siderakb/pmw3360-pcb/pmw3360_pcb_ffc/readme.md

# PMW3360 PCB FFC/FPC Connector

- `J1`: 0.5mm 8pin FFC/FPC connector (AFC01-S08FCA-00).
- Mounting holes: 4x M2 (∅2.2mm).

## PCB Characteristics

- Copper layer count: 2
- Board overall dimensions: 27 mm x 22.5 mm
- Min track/spacing: 0.2 mm / 0.2 mm
- Min hole diameter: 0.3 mm
- Castellated pads: No
- Plated board edge: No
- Edge card connectors: No

## Changelog

### [F.1.0] - 2023-12-15

- Changed LDO from TPS73601DBV to TLV74318PDBVR.
- Changed R5 to C5.

### [F.0.0] - 2023-06-29

- Reduce the board size to 27 x 22.5 mm.
- Update PWM3360 footprint (reduce the size of the pads).

### [3.1.0] - 2023-05-27

- First FFC/FPC edition release.
