siderakb/pmw3360-pcb/pmw3360_pcb_jst/readme.md

# PMW3360 PCB JST GH Connector

- `J1`: JST GH 1.25mm connector (SM08B-GHS-TB(LF)(SN)).
- Mounting holes: 4x M2 (∅2.2mm).

## PCB Characteristics

- Copper layer count: 2
- Board overall dimensions: 27 mm x 28 mm
- Min track/spacing: 0.2 mm / 0.2 mm
- Min hole diameter: 0.3 mm
- Castellated pads: No
- Plated board edge: No
- Edge card connectors: No

## Changelog

### [J.1.0] - 2023-12-15

- Changed LDO from TPS73601DBV to TLV74318PDBVR.
- Changed R5 to C5.

### [J.0.0] - 2023-06-29

- Update PWM3360 footprint (reduce the size of the pads).

### [3.0.0] - 2023-05-27

- First JST edition release.
