siderakb/pmw3360-pcb/pmw3360_pcb_jst/pmw3360_pcb_jst.kicad_pcb

## KiCad design pmw3360_pcb_jst/pmw3360_pcb_jst.kicad_pcb (2023-12-15)

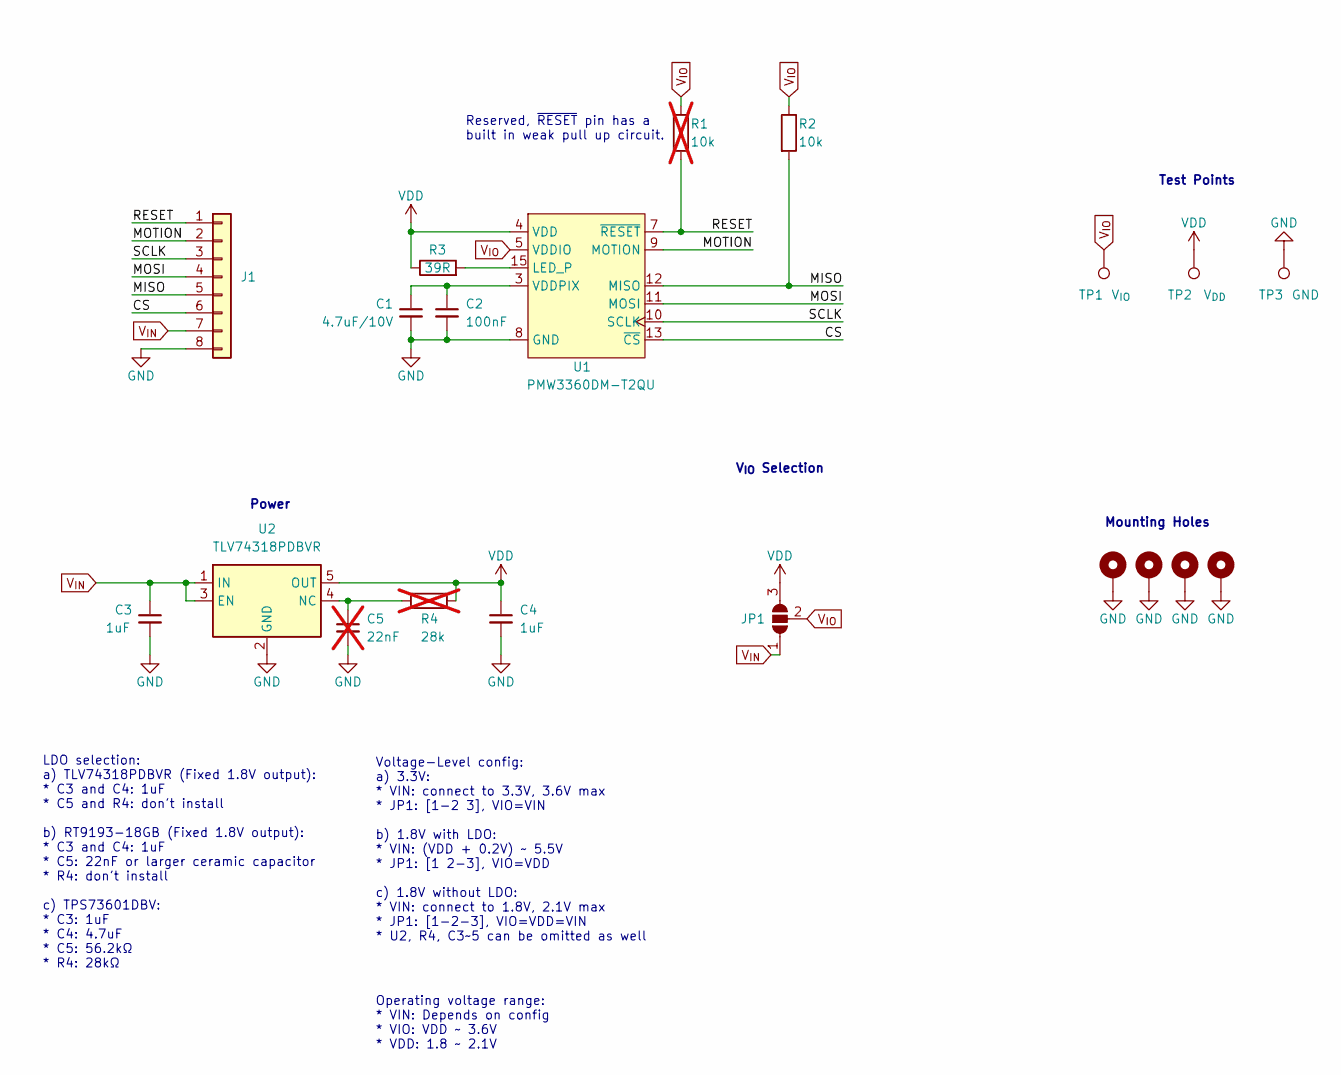
[picture p4: schematic pmw3360_pcb_jst.kicad_sch, PMW3360 PCB]

Parts:
C1: 4.7uF/10V; C_0603_1608Metric_Pad1.08x0.95mm_HandSolder
C2: 100nF; C_0603_1608Metric_Pad1.08x0.95mm_HandSolder
C3, C4: 1uF; C_0603_1608Metric_Pad1.08x0.95mm_HandSolder
C5: 22nF; C_0603_1608Metric_Pad1.08x0.95mm_HandSolder; Mfr. # CL10B223KB8NNNC; LCSC C21122; not fitted
H1, H2, H3, H4: MountingHole_Pad; MountingHole_2.2mm_M2_ISO14580_Pad
J1: Conn_01x08; JST_GH_SM08B-GHS-TB_1x08-1MP_P1.25mm_Horizontal
JP1: SolderJumper_3_Open; SolderJumper-3_P1.3mm_Open_RoundedPad1.0x1.5mm_NumberLabels
R1: 10k; R_0603_1608Metric_Pad0.98x0.95mm_HandSolder; not fitted
R2: 10k; R_0603_1608Metric_Pad0.98x0.95mm_HandSolder
R3: 39R; R_0603_1608Metric_Pad0.98x0.95mm_HandSolder
R4: 28k; R_0603_1608Metric_Pad0.98x0.95mm_HandSolder; not fitted
TP1: V_{IO}; TestPoint_Pad_D1.0mm
TP2: V_{DD}; TestPoint_Pad_D1.0mm
TP3: GND; TestPoint_Pad_D1.0mm
U1: PMW3360DM-T2QU; PMW3360DM-T2QU 16Pin
U2: TLV74318PDBVR; SOT-23-5; Mfr. # TLV74318PDBVR; LCSC C485152

Connections:
/CS: J1.6, U1.13 (~CS)
/MISO: J1.5, R2.2, U1.12 (MISO)
/MOSI: J1.4, U1.11 (MOSI)
/MOTION: J1.2, U1.9 (MOTION)
/RESET: J1.1, R1.2, U1.7 (~RESET)
/SCLK: J1.3, U1.10 (SCLK)
GND: C1.2, C2.2, C3.2, C4.2, C5.2, H1.1, H2.1, H3.1, H4.1, J1.8, TP3.1, U1.8 (GND), U2.2 (GND)
unnamed: R3.2, U1.15 (LED_P)
unnamed: C1.1, C2.1, U1.3 (VDDPIX)
unnamed: C5.1, R4.2, U2.4 (NC)
VDD: C4.1, JP1.3 (B), R3.1, R4.1, TP2.1, U1.4 (VDD), U2.5 (OUT)
V_{IN}: C3.1, J1.7, JP1.1 (A), U2.1 (IN), U2.3 (EN)
V_{IO}: JP1.2 (C), R1.1, R2.1, TP1.1, U1.5 (VDDIO)

Notes on the sheet:
Mounting Holes
Test Points
V_{IO} Selection
LDO selection: a) TLV74318PDBVR (Fixed 1.8V output): * C3 and C4: 1uF * C5 and R4: don't install b) RT9193-18GB (Fixed 1.8V output): * C3 and C4: 1uF * C5: 22nF or larger ceramic capacitor * R4: don't install c) TPS73601DBV: * C3: 1uF * C4: 4.7uF * C5: 56.2kΩ * R4: 28kΩ
Operating voltage range: * VIN: Depends on config * VIO: VDD ~ 3.6V * VDD: 1.8 ~ 2.1V
Power
Reserved, ~{RESET} pin has a built in weak pull up circuit.
Voltage-Level config: a) 3.3V: * VIN: connect to 3.3V, 3.6V max * JP1: [1-2 3], VIO=VIN b) 1.8V with LDO: * VIN: (VDD + 0.2V) ~ 5.5V * JP1: [1 2-3], VIO=VDD c) 1.8V without LDO: * VIN: connect to 1.8V, 2.1V max * JP1: [1-2-3], VIO=VDD=VIN * U2, R4, C3~5 can be omitted as well

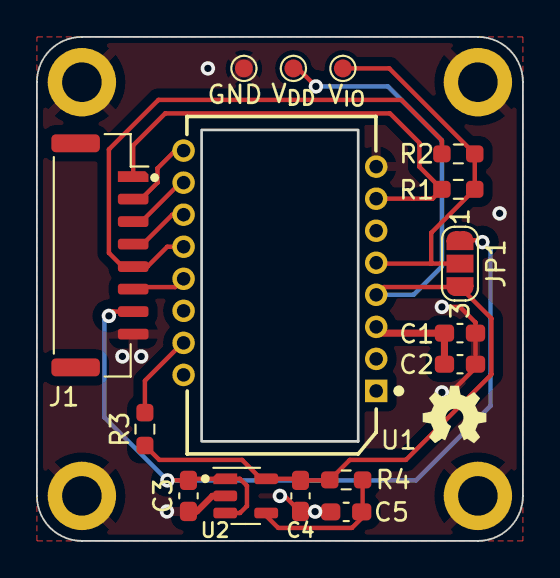
[picture p5: board pmw3360_pcb_jst.kicad_pcb from above]

Board: 2 copper layers, 27.0 x 28.0 mm, 20 parts (0 on the bottom side), 13 nets.
