siderakb/pmw3360-pcb/(commit log)

2022-08-20 Add KiCAD files
    [PMW3360_PCB.kicad_pcb, PMW3360_PCB.kicad_sch, PMW3360_PCB_1.kicad_pcb]
2022-10-13 Remove unused file
    [PMW3360_PCB_1.kicad_pcb]
2022-10-13 Add license info
    [PMW3360_PCB.kicad_pcb, PMW3360_PCB.kicad_sch]
2022-10-14 Update power net name
    [PMW3360_PCB.kicad_pcb, PMW3360_PCB.kicad_sch]
2022-10-14 Add mounting hole dimension
    [PMW3360_PCB.kicad_pcb]
2022-10-20 Deleted unconnect end track
    [PMW3360_PCB.kicad_pcb]
2022-12-27 Update Rev 3.0
    [PMW3360_PCB.kicad_pcb, PMW3360_PCB.kicad_sch]
2023-02-01 Update date
    [PMW3360_PCB.kicad_pcb]
2023-02-26 Replace JST GH 1.25 connector with 0.5mm FPC
    [PMW3360_PCB.kicad_pcb, PMW3360_PCB.kicad_sch]
2023-04-29 Add footprint and symbol library path table
2023-04-29 Reduce board size
    [PMW3360_PCB.kicad_pcb, PMW3360_PCB.kicad_sch]
2023-06-28 Update schematic
    [PMW3360_PCB.kicad_pcb, PMW3360_PCB.kicad_sch]
2023-06-29 Add sheet comments
    [PMW3360_PCB.kicad_pcb, PMW3360_PCB.kicad_sch]
2023-06-29 Add v3.0 back
    [pmw3360_pcb_jst.kicad_pcb, pmw3360_pcb_jst.kicad_sch]
2023-06-29 Add rev2 back
    [pmw3360_pcb_pinheader.kicad_pcb, pmw3360_pcb_pinheader.kicad_sch]
2023-06-29 Update symbol references
    [pmw3360_pcb_ffc.kicad_pcb, pmw3360_pcb_ffc.kicad_sch]
2023-06-29 Update silkscreen text
    [pmw3360_pcb_pinheader.kicad_pcb]
2023-06-29 Add FFC readme.md
    [pmw3360_pcb_ffc.kicad_pcb, pmw3360_pcb_ffc.kicad_sch]
2023-06-29 Add JST readme.md
    [pmw3360_pcb_jst.kicad_pcb, pmw3360_pcb_jst.kicad_sch]
2023-06-29 Modify PinHeader Rev from `2.2` to `P.0`
    [pmw3360_pcb_pinheader.kicad_pcb, pmw3360_pcb_pinheader.kicad_sch]
2023-10-07 Change pin header edition LDO to TLV74318PDBVR
    [pmw3360_pcb_pinheader.kicad_pcb, pmw3360_pcb_pinheader.kicad_sch]
2023-11-14 Change hardware license to CERN-OHL-P v2
    [pmw3360_pcb_ffc.kicad_pcb, pmw3360_pcb_ffc.kicad_sch, pmw3360_pcb_jst.kicad_pcb, pmw3360_pcb_jst.kicad_sch, pmw3360_pcb_pinheader.kicad_pcb, pmw3360_pcb_pinheader.kicad_sch]
2023-12-15 Add SPI clock setting
2023-12-15 Update designators
    [pmw3360_pcb_ffc.kicad_pcb, pmw3360_pcb_ffc.kicad_sch, pmw3360_pcb_jst.kicad_pcb, pmw3360_pcb_jst.kicad_sch]
