siderakb/pmw3360-pcb/(notices)

Notices in the files:
pmw3360_pcb_jst/pmw3360_pcb_jst.kicad_sch:
Open Source Hardware, CERN-OHL-P v2
README.md:
License: CERN-OHL-P v2
PMW3360_PCB/PMW3360_PCB.kicad_pcb:
MIT License, Open Source Hardware
